ezzat3mmar/ECE_26-Electronics_Measurments_Project/Docs/Digitally_Controlled_Buck_Converter_presentation.pdf

E L E C T R O N I C S M E A S U R E M E N T P R O J E C T

3rd Year Undergraduate

Electronics & Communications

Engineering Department

## Tanta University

Faculty of Engineering

D E S I G N A N D I M P L E M E N T A T I O N O F A

# Digitally Controlled Low-Side Buck Converter Prototype

# with Closed-Loop PI Control

## Presented by: 1-Mahmoud Alaa Elfert 2-Ezzat Saied Ammar 3-Ahmed Ali El-attar 4-Siraj Atef Siraj 5-Reda Ibrahim

Supervised by: Professor Hager Foda | Academic Year: 2025–2026

Power Electronics · Embedded Systems · Digital Control Theory

# Project Overview & Motivation

A Buck (step-down) DC-DC converter regulates a lower output voltage from a higher input. This project replaces analog compensation networks with fully digital, firmware-based PI control using an Arduino Nano (ATmega328P)— providing superior tunability, portability, and real-time adaptability without dedicated analog ICs.

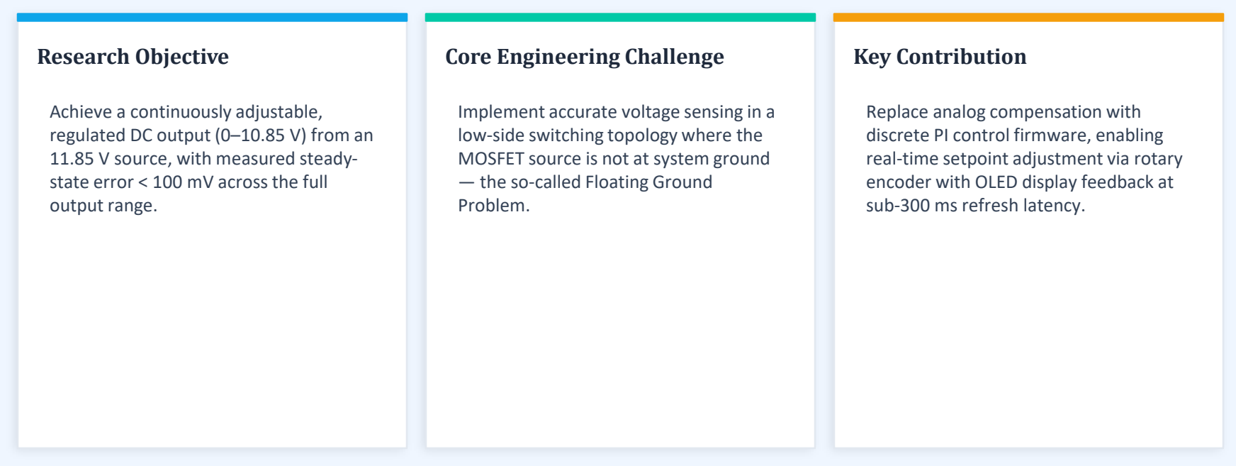
[picture p2: figure]
Research Objective; Achieve a continuously adjustable, regulated DC output (0–10.85 V) from an 11.85 V source, with measured steady- state error < 100 mV across the full output range.; Core Engineering Challenge; Implement accurate voltage sensing in a low-side switching topology where the MOSFET source is not at system ground — the so-called Floating Ground Problem.; Key Contribution; Replace analog compensation with discrete PI control firmware, enabling; encoder with OLED display feedback at sub-300 ms refresh latency.

real-time setpoint adjustment via rotary

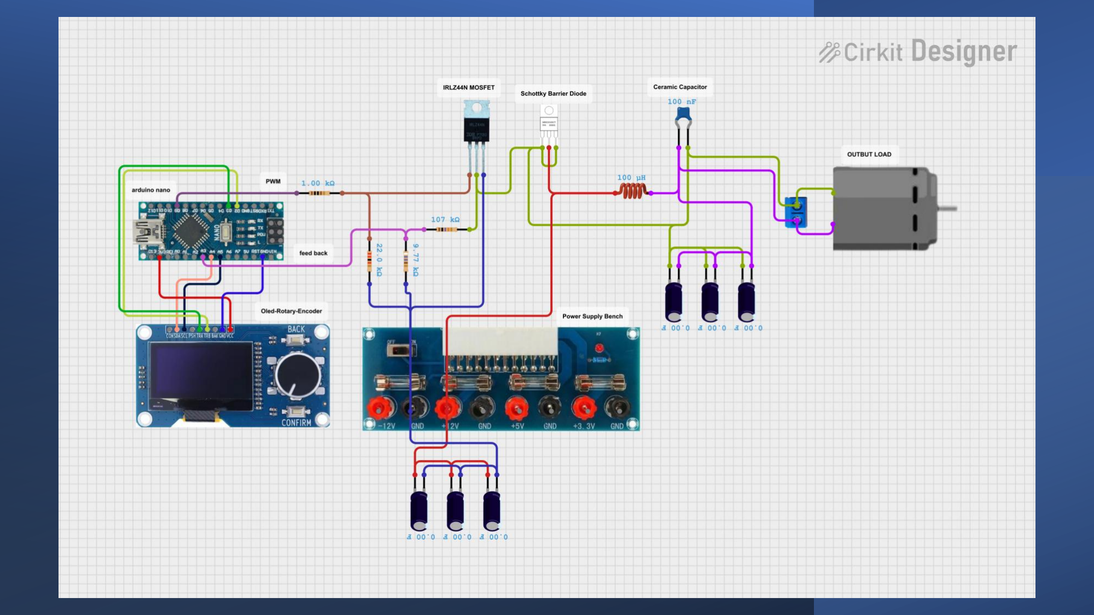
[picture p3: page 3]

# Complete System Architecture

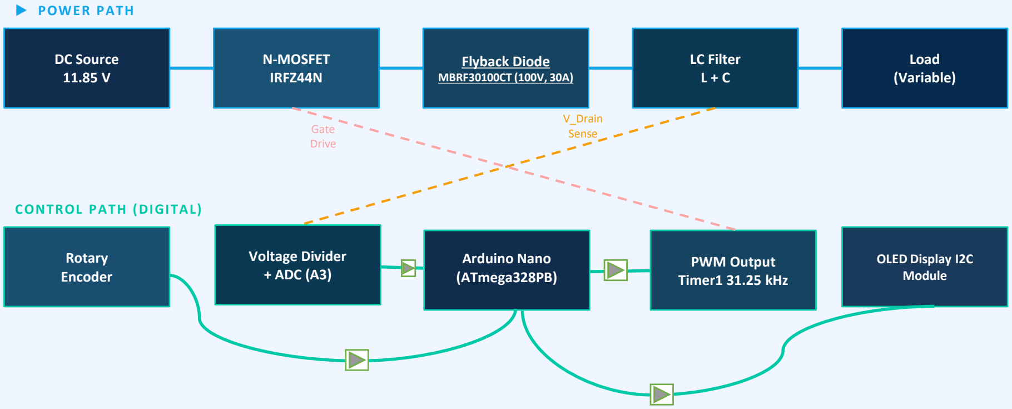
[picture p4: figure]
POWER PATH; DC Source 11.85 V; N-MOSFET IRFZ44N; Flyback Diode MBRF30100CT (100V, 30A); LC Filter L + C; Load (Variable); CONTROL PATH (DIGITAL); Rotary Encoder; Arduino Nano (ATmega328PB); PWM Output Timer1 31.25 kHz; Voltage Divider + ADC (A3); OLED Display I2C Module; Gate Drive; V_Drain Sense

Power Flow | Control Signal | Feedback Path | Gate Drive

# Hardware Topology: Low-Side N-Channel MOSFET Switching

### N-Channel MOSFET (IRFZ44N) — Superior Rds(on)

N-channel devices exhibit significantly lower ON-state resistance (Rds(on) = 17.5 mΩ @ Vgs = 10 V) compared to P-channel equivalents of the same die area, due to higher electron mobility. This directly minimises conduction losses (P_cond = Id² × Rds(on)) and thermal dissipation at the switching element.

### Low-Side Topology — Direct Gate Drive, No Bootstrap

Placing the MOSFET between the load return path and system ground (low-side configuration) allows the microcontroller's 5 V PWM output to drive the gate directly. A P-channel or high-side N-channel configuration would require a chargepump gate driver or bootstrap capacitor circuit, adding BOM cost and PCB complexity.

### Flyback (Freewheeling) Diode — MBRF30100CT Schottky

During the MOSFET OFF state, inductor current continuity demands a return path. The MBRF30100CT diode( Vf =0.84 V@ 15 A) provides this essential freewheeling path for the main inductor and motor, preventing destructive back-EMF spikes and maintaining Continuous Conduction Mode (CCM)."

C OMP ON E N T S P E C IF IC ATION S

Parameter | Value
Switch Device | IRFZ44N N-MOSFET
Rds(on) | 17.5 mΩ @ Vgs=10V
Vds(max) | 55 V
Id(max) | 49 A
Vgs(th) | 2–4 V
Freewheeling | MBRF30100CT Schottky
Vf (Schottky) | ~0.84V @ 15A
Input Voltage | 11.85 V
PWM Frequency | 31.25 kHz
PWM Resolution | 8-bit (0–255)

# Differential Voltage Sensing: The Floating Ground Problem

## Topology-Induced Measurement Constraint

In the low-side topology, the MOSFET drain alternates between V_Source and V_GND on every switching cycle — it is NOT at a fixed DC potential. A direct ADC measurement of V_Drain therefore does not represent V_Load. Instead, the differential relationship across the load must be applied:

# V_Load = V_Source − V_Drain

where V_Drain is sampled via the precision voltage divider at ADC pin A3

// readAndAdjust() — Differential Sensing Implementation

float vDrain = (avgRaw * refVoltage / 1023.0) / dividerRatio;

actualVoltage = (sourceVoltage - vDrain) * calFactor;

if (actualVoltage < 0) actualVoltage = 0;

LOW-SIDE TOPOLOGY (Schemati c)

V_Source (11.85V)

V_Load | LOAD

N-MOS
(Drain) | → V_Drain (ADC sense)

GND

# ADC Precision Architecture: Three-Layer Strategy

01

## Internal Bandgap Reference — V_ref = 1.107 V (Measured)

The ATmega328P's VCC rail is subject to ±5% variation (±250 mV), degrading ADC measurement integrity. The built-in bandgap reference (nominally 1.1 V, measured precisely at 1.107 V with a calibrated bench multimeter) is temperature-stable and VCC-independent. The resulting ADC LSB = 1.107 V / 1023 ≈ 1.08 mV — a 4.5× improvement in LSB resolution versus the 5 V reference. Activated via: analogReference(INTERNAL)

02

## Custom Voltage Divider — R₁ = 107.3 kΩ, R₂ = 9.77 kΩ, β = 0.083454

The divider ratio β = R₂ / (R₁ + R₂) = 9.77 / (107.3 + 9.77) = 0.083454 scales V_Drain (0–12 V) into the ADC input range (0–1.107 V). Highimpedance resistors minimise shunt current loading on the power path. The exact measured ratio is embedded directly in firmware to account for 1% component tolerances, rather than relying on nominal design values.

03

## Software Calibration Factor — k = 0.92 (Empirically Derived)

After hardware compensation, a residual systematic offset remained between computed and physically measured output voltages — attributable to unmeasured parasitic resistances in PCB traces, probe contact resistance, and inductor DCR. A multiplicative factor k = (V_measured / V_computed) = 0.92 was derived empirically and applied in firmware as a final correction stage.

V_Drain = (avgRaw × 1.107 / 1023.0) / 0.083454 | → | actualVoltage = (11.85 − V_Drain) × 0.92

# High-Frequency PWM: Timer1 Prescaler Configuration

## Problem: Default 490 Hz Falls in the Audible Band

Arduino's default Timer1 PWM frequency (490 Hz) lies within the human audible range (20 Hz – 20 kHz). At this frequency, the energy storage inductor oscillates audibly under repetitive magnetic flux variations, producing acoustic noise — an unacceptable artefact. A lower frequency also demands a physically larger inductance for equivalent output ripple (ΔiL = V_out·(1-D )/ (L·f_sw)).

## Solution: Prescaler = 1 → f_PWM = 31.25 kHz

Manipulating the TCCR1B clock-select bits (CS12:CS11:CS10 = 0:0:1) sets prescaler N=1, directly clocking Timer1 from the 16 MHz system oscillator. In phase-correct 8-bit PWM mode, the switching frequency is:

## f_PWM = f_CPU / (2 × N × 256) = 16 MHz / (2 × 1 × 256)

= 31,250 Hz

// setup() — Timer1 Register Manipulation (TCCR1B)
TCCR1B = (TCCR1B & 0b11111000) | 0x01; // CS10=1: prescaler
N=1

P RE S C ALE R S E LE C TION MATRIX

Prescaler N | f_PWM | In Audible Band?
1024 | ~30 Hz | No (sub-audio)
256 | 122 Hz | No (sub-audio)
64 (default) | 490 Hz | YES ✗
8 | 3.92 kHz | YES ✗
1 ← CHOSEN | 31.25 kHz | No ✓

# Signal Integrity & Noise Suppression Strategy

## Hardware: Decoupling Capacitor Network

Root Cause: The switching MOSFET draws discontinuous (pulsed) current from the supply bus. Each transition generates a rapid di/dt transient. Via Lenz's law (v = L·di/dt), parasitic PCB trace and wire inductance induces voltage spikes onto V_Source, corrupting both the ADC reference and voltage measurements.

Solution: Large bulk electrolytic capacitors (470–1000 µF) across the input bus act as a local charge reservoir, supplying transient current during switch-on and absorbing voltage spikes during switch-off. Small ceramic bypass capacitors (100 nF) at the ADC pin suppress switching harmonics above 1 MHz. Together, this maintains V_Source stability within ±50 mV across switching cycles.

Eliminates supply-induced ADC measurement errors and prevents saturation during fast switching transients.

## Firmware: Digital Oversampling (N = 100 Samples)

Theory: By averaging N = 100 independent ADC samples per control cycle, the random (white) noise component is attenuated by √N ≈ 10. The SNR improvement equals 20·log₁₀(10) = 20 dB, equivalent to extending ADC resolution by log₂(10) ≈ 3.32 bits — yielding an effective resolution of ~13.3 bits under white-noise conditions
(ENOB improvement via oversampling).

// 100-sample oversampling for noise rejection

long sum = 0;
for(int i = 0; i < 100; i++) {
sum += analogRead(feedbackPin);
}
float avgRaw = sum / 100.0;
SNR improvement: +20 dB | Effective resolution: ~13.3 bits

# Closed-Loop Control: Discrete PI Controller Implementation

## Continuous: u(t) = Kp·e(t) + Ki·∫e(t) dt Discrete: u[n] = Kp·e[n] + Ki · Σ( Tc · e[k] )

Kp = 5.0

### Proportional Gain

Delivers immediate corrective action proportional to the instantaneous voltage error e[n] = V_set − V_out. Dominant
corrective term for large
deviations; tuned to achieve fast rise time without generating overshoot in the step response.

Ki = 0.1

### Integral Gain

Accumulates error over time to eliminate steady-state offset — a fundamental limitation of proportional-only control. Conservatively sized at 0.1 to prevent integrator windup
under rapid setpoint changes.

±50

# Clamp

### Anti-Windup Guard

The error integral is hardclamped to [−50, +50] via
constrain(). Prevents integrator windup — the pathological
condition where a saturated actuator accumulates
unbounded integral error,
causing severe overshoot and extended recovery time.

±0.05V

# Dead

### Deadband Control

PI action is suppressed and the integral is reset when |e[n]| ≤ 0.05 V. This prevents limit-cycle oscillation (hunting) — the high-frequency toggling of PWM
output caused by noise-induced oscillation around the setpoint.

# Firmware Architecture: Non-Blocking Cooperative Multitasking

The firmware employs a cooperative multitasking model using the millis() 32-bit hardware counter — eliminating blocking delay() calls that stall the MCU and prevent concurrent task execution. Each subsystem is assigned an independent update period, evaluated via timestamp comparison on every main loop iteration. This allows the control loop, display refresh, and encoder polling to execute at independent, decoupled rates.

Task | Period | Priority | Mechanism | Engineering Rationale
Rotary Encoder Decode | Every loop | Critical | Encoder lib + Hardware Interrupts | Quadrature decoding requires edge-sensitive counting on every main-loop pass; latency > 1 loop-pass risks missed pulses
PI Control Loop | 60 ms | High | millis() timestamp | Control bandwidth ≈ 16.7 Hz — sufficient for slow output voltage dynamics; budget allows 100-sample ADC window
100-sample ADC Average | (within PI) | High | Blocking for-loop (~5 ms) | Nested within 60 ms control slot; 5 ms execution time does not violate system non-blocking contract
PWM Output Write | On PI update | Critical | analogWrite() → Timer1 | Updated each PI iteration; reflects latest corrective action to hardware switch without additional latency
OLED Display Refresh | 300 ms | Low | millis() timestamp | Above human flicker threshold; reduces I²C bus contention and avoids starving the time-critical control loop

* Interrupt-driven quadrature decoding provided by the Encoder library (Paul Stoffregen). The 100-sample ADC loop (~5 ms) is a controlled blocking segment nested within the 60 ms control budget and does not violate the system-level non-blocking contract.

# System Specifications & Design Parameters

## Power Stage

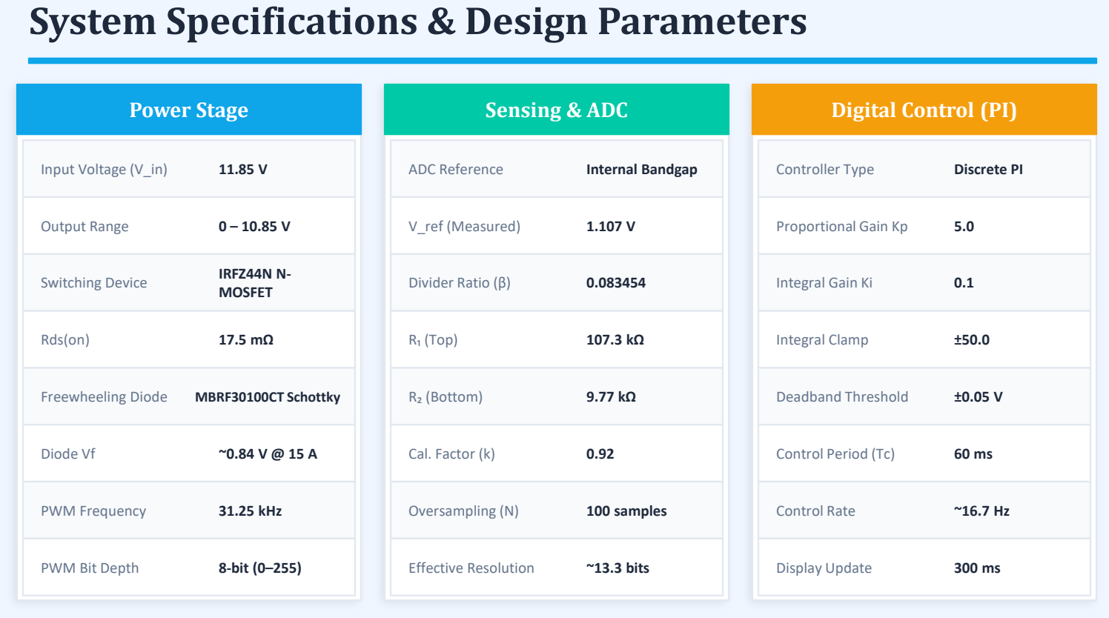
[picture p5: page 12]

Input Voltage (V_in) | 11.85 V
Output Range | 0 – 10.85 V
Switching Device | IRFZ44N N- MOSFET
Rds(on) | 17.5 mΩ
Freewheeling Diode | MBRF30100CT Schottky
Diode Vf | ~0.84 V @ 15 A
PWM Frequency | 31.25 kHz
PWM Bit Depth | 8-bit (0–255)

## Sensing & ADC

ADC Reference | Internal Bandgap
V_ref (Measured) | 1.107 V
Divider Ratio (β) | 0.083454
R₁ (Top) | 107.3 kΩ
R₂ (Bottom) | 9.77 kΩ
Cal. Factor (k) | 0.92
Oversampling (N) | 100 samples
Effective Resolution | ~13.3 bits

## Digital Control (PI)

Controller Type | Discrete PI
Proportional Gain Kp | 5.0
Integral Gain Ki | 0.1
Integral Clamp | ±50.0
Deadband Threshold | ±0.05 V
Control Period (Tc) | 60 ms
Control Rate | ~16.7 Hz
Display Update | 300 ms

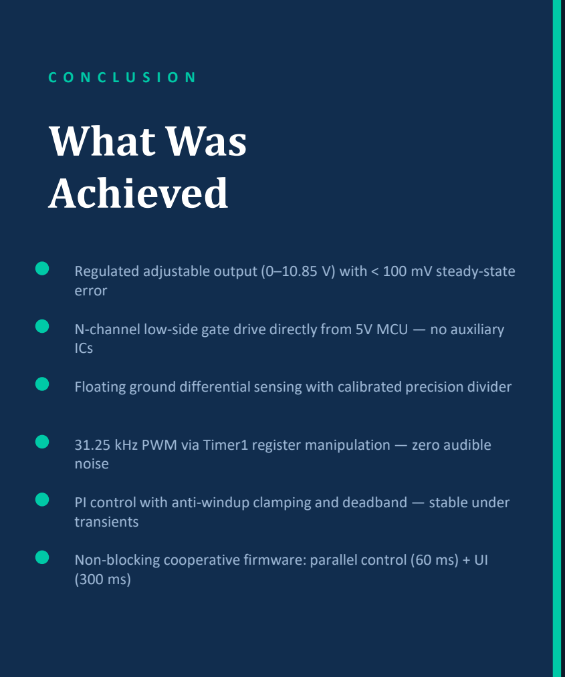
[picture p6: figure]
C O N C L U S I O N What Was Achieved; error; ICs; noise; transients

Regulated adjustable output (0–10.85 V) with < 100 mV steady-state

N-channel low-side gate drive directly from 5V MCU — no auxiliary

Floating ground differential sensing with calibrated precision divider

31.25 kHz PWM via Timer1 register manipulation — zero audible

PI control with anti-windup clamping and deadband — stable under

Non-blocking cooperative firmware: parallel control (60 ms) + UI

# Future Work & System Upgrades

### Current Sensing & Overcurrent Protection

Integration of an inline shunt resistor or Hall-effect sensor (ACS712) enables an inner current control loop, output current limiting, and short-circuit protection — mandatory for any production-grade power supply design.

### Synchronous Buck Topology (Active Rectification)

Replace the MBRF30100CT Schottky freewheeling diode with a synchronous N-MOSFET switch. Eliminates the Vf ≈ 0.84 V conduction loss, improving efficiency at high duty cycles. Requires precise dead-time management to prevent shoot-through.

### PID Controller + Kalman Filter / State Observer

Add a derivative term (Kd) with a first-order IIR low-pass filter to suppress noise amplification inherent to differentiation. A discrete Kalman filter or state-space observer would further improve transient load rejection.

- Electronics & Communications Engineering · Tanta University · 2025–2026

## Future Roadmap

# Phase II: Productization

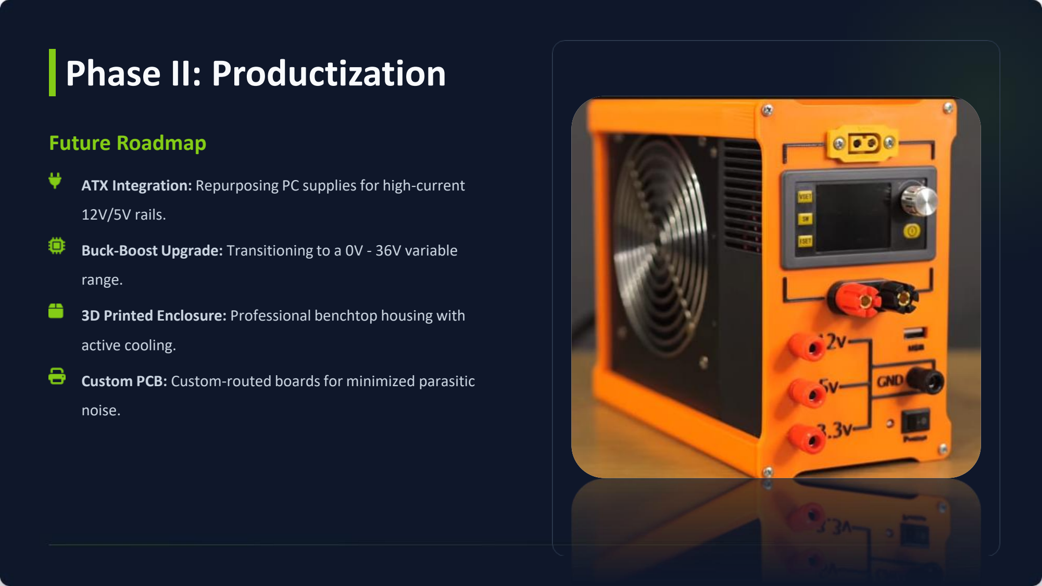
[picture p7: page 14]

### ATX Integration: Repurposing PC supplies for high-current

12V/5V rails.

### Buck-Boost Upgrade: Transitioning to a 0V - 36V variable

range.

### 3D Printed Enclosure: Professional benchtop housing with

active cooling.

### Custom PCB: Custom-routed boards for minimized parasitic

noise.
