ezzat3mmar/ECE_26-Electronics_Measurments_Project/photos/IMG_20260508_204428.jpg

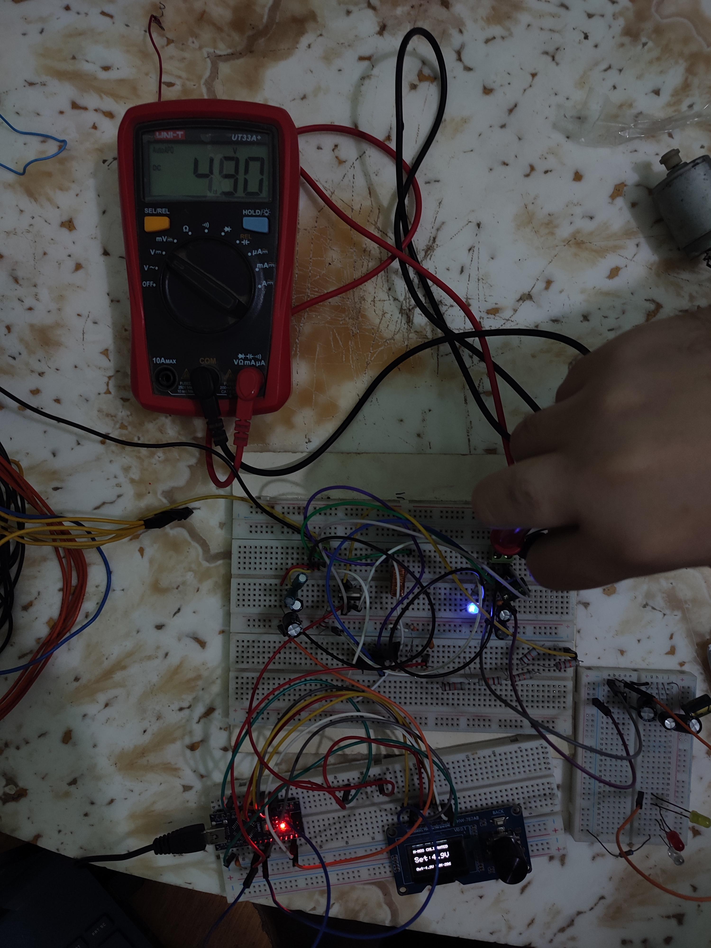
photos/IMG_20260508_204428.jpg
