ezzat3mmar/ECE_26-Electronics_Measurments_Project/(commit log)

2026-05-20 Add the schematic to photos
2026-05-20 Revise README for digitally controlled buck converter project
    Updated project title and provided a comprehensive overview, system architecture, firmware strategy, hardware components, required libraries, and technical specifications.
2026-05-21 Add Project Schematic
2026-05-21 Add Project Schematic to README
